sensics/Latency-Test/cmake/module-docs/AllModuleDependencies.pdf

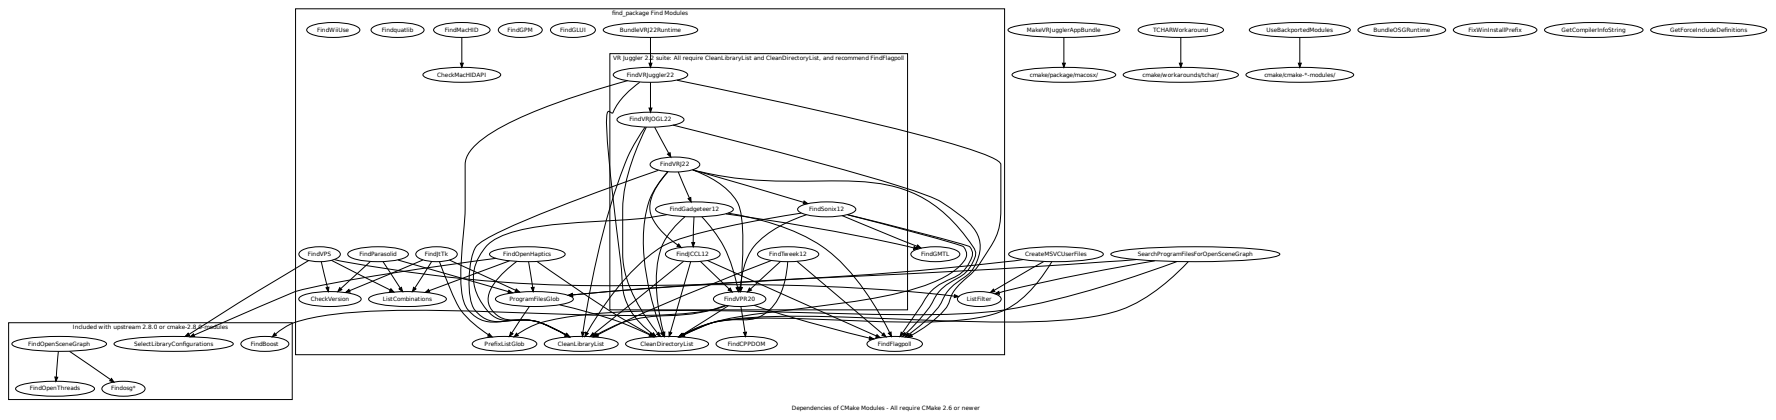
[picture p4: page 1]
find_package Find Modules; FindOpenSceneGraph; SelectLibraryConfigurations; FindBoost; FindOpenThreads; Findosg*; cmake/package/macosx/; cmake/workarounds/tchar/; cmake/cmake-*-modules/; BundleVRJ22Runtime; BundleOSGRuntime; CheckMacHIDAPI; FindVRJuggler22; CheckVersion; CleanLibraryList; CleanDirectoryList; CreateMSVCUserFiles; ProgramFilesGlob; ListFilter; PrefixListGlob; FixWinInstallPrefix; GetCompilerInfoString; GetForceIncludeDefinitions; ListCombinations; MakeVRJugglerAppBundle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

VR Juggler 2.2 suite: All require CleanLibraryList and CleanDirectoryList, and recommend FindFlagpoll

Included with upstream 2.8.0 or cmake-2.8.0-modules

Dependencies of CMake Modules - All require CMake 2.6 or newer
