sensics/Latency-Test/(commit log)

2015-02-02 Added functioning photodiode latency testing program. Added start on an OSVR latency-testing firmware program. Both for loading onto an Arduino.
2015-02-02 Modified the photosensor latency test to use a different threshold for on and off detection to reduce the latency between when the actual brightness changes and when the program detects it. This new 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
2015-02-03 Adding documentation on the latency-test hardware. Version 1.0 (not polished, but describes how to obtain, build, and run the Arduino-side code to test latency.
2015-02-03 Put back in the code that reads both registers from the inertial unit; reading just the high bytes did not work. Added debugging defines and selected thresholds that work better. Fixed a bug in the p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
    [OSVR_Latency_hardware_firmware.ino]
2015-02-13 Version 1.2.0 lets you teleport the mouse with the middle button and flash the screen color with the right button. Improves the following behavior for the left mouse button.
2015-02-13 Reduced threshold for photosensor on hardware latency test, simplified printout. Improved documentation. Added program to print the photosensor values.
2015-02-21 Cleaning up code to avoid redundant operations. Behavior is the same.
    [opengl_widget.cpp, opengl_widget.h]
2015-02-21 Added command-line arguments to have it talk with a VRPN button, analog, or tracker device and strobe the background when it detects a change above threshold.
2015-02-22 Added a command-line option to specify the number of quads to draw each frame to let us see how latency varies with graphics load. This initial version uses immediate mode to send the quads. We shoul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
2015-02-23 Version 3.0.0 of the firmware computes and prints an average latency every 16 changes, doing the even and odd changes separately to handle cases where one pair of a transition is slower than the othe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
2015-02-24 Adding a program to print the inertial sensor values.
2015-08-30 Adding program to print out a specified subset of the analog values on a regular basis.
2015-12-22 Fixed a bug that kept Ardiuno code from compiling under a more-recent compiler.
    [motion_onset_test.ino]
